Heber-co-uk/MultiPi/README.md

# MultiPi
Heber MultiPi and MultiPi JAMMA repository for useful information and manuals
