Heber-co-uk/MultiPi/MultiPi-Cart-Templates/MultiPi-Cart-PCB.pdf

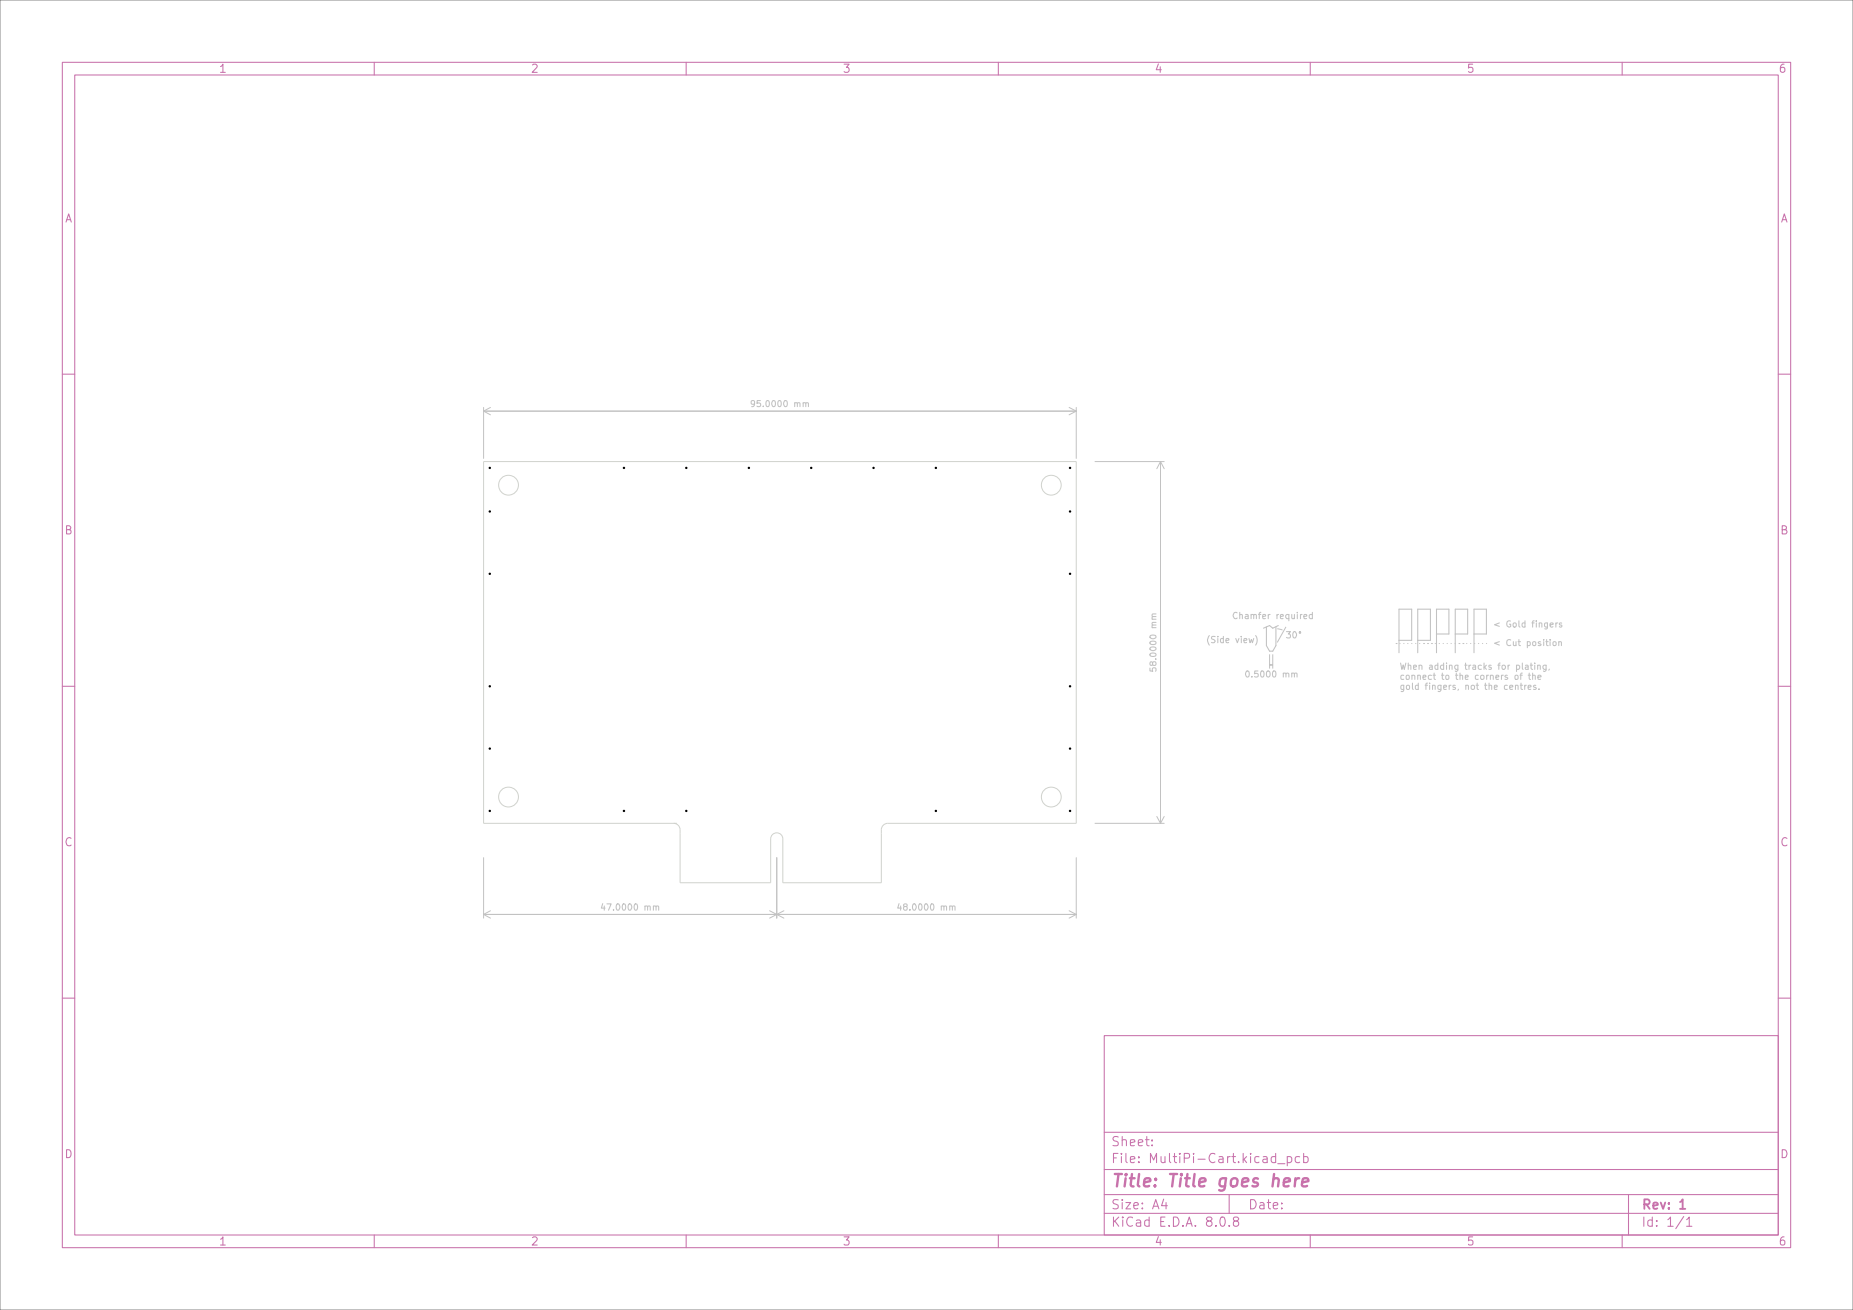
[picture p59: page 1]
