Heber-co-uk/MultiPi/MultiPi-Cart-Templates/MultiPi-Cart.pdf

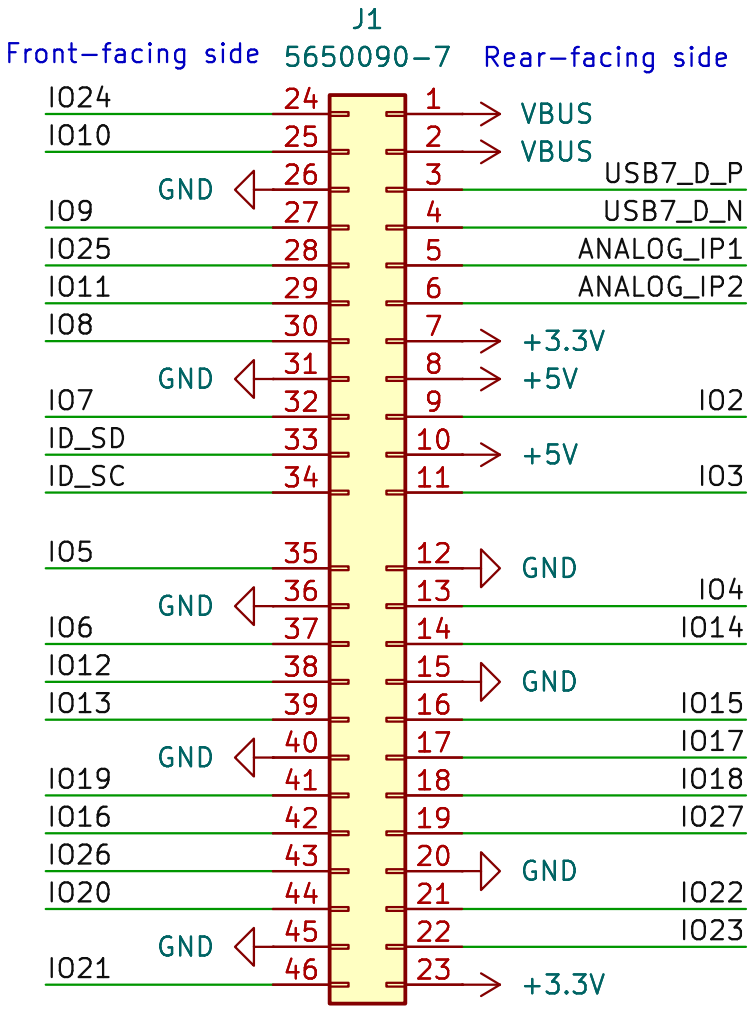
[picture p58: page 1]

File: MultiPi-Cart.kicad_sch Sheet: /
Id: 1/1 Title: Title goes here
